SSL-Roots/Circuit_MainBoard/MainCircuit - シート1.pdf

Part | Value | 耐圧・電力 | Package | 購入先 | 単価
+B-CONE | XT60 | - | XT60 | amazon | ¥129.00
FUSE | 3413.0328.22(8A) | 8A | 3216 | DigiKey | ¥44.50
BOOST_CONE | B12B-XASK-1 | - | XA12pin | RS | ¥96.10
C100 | 0.01u | 25V | C1608 | 秋月電子 | ¥1.00
C102 | 0.1u | 25V | C1608 | 秋月電子 | ¥2.00
C103 | 0.1u | 25V | C1608 | 秋月電子 | ¥2.00
C104 | 0.1u | 25V | C1608 | 秋月電子 | ¥2.00
C105 | 10u | 25V | C2012 | 秋月電子 | ¥5.00
C150 | 100u | 25V | 6ｍｍ | 秋月電子 | ¥10.00
C151 | 100u | 25V | 6ｍｍ | 秋月電子 | ¥10.00
C152 | 100u | 25V | 6ｍｍ | 秋月電子 | ¥10.00
C153 | 100u | 25V | 6ｍｍ | 秋月電子 | ¥10.00
C201 | 0.01u | 25V | C1608 | 秋月電子 | ¥1.00
C202 | 0.01u | 25V | C1608 | 秋月電子 | ¥1.00
C203 | 0.01u | 25V | C1608 | 秋月電子 | ¥1.00
C204 | 0.01u | 25V | C1608 | 秋月電子 | ¥1.00
C205 | 0.1u | 25V | C1608 | 秋月電子 | ¥2.00
C206 | 0.1u | 25V | C1608 | 秋月電子 | ¥2.00
C207 | 0.1u | 25V | C1608 | 秋月電子 | ¥2.00
C208 | 0.1u | 25V | C1608 | 秋月電子 | ¥2.00
C301 | 0.1u | 25V | C1608 | 秋月電子 | ¥2.00
C302 | 0.1u | 25V | C1608 | 秋月電子 | ¥2.00
C303 | 0.1u | 25V | C1608 | 秋月電子 | ¥2.00
C305 | 0.1u | 25V | C1608 | 秋月電子 | ¥2.00
C306 | 1u | 50V | C1608 | 秋月電子 | ¥1.20
C307 | 1u | 50V | C1608 | 秋月電子 | ¥1.20
C308 | 0.047u | 50V | C1608 | 秋月電子 | ¥2.00
C400 | 未実装 | - | C1608 | - | -
C401 | 1u | 50V | C1608 | 秋月電子 | ¥1.20
C402 | 100u | 25V | 6ｍｍ | 秋月電子 | ¥10.00
C500 | 0.047u | 50V | C1608 | 秋月電子 | ¥2.00
D100 | HRF502A | - | DO214AC | 秋月電子 | ¥50.00
D400 | 未実装 | - | 1608 | - | -
D401 | CDBA3150-HF | - | DO214AC | DigiKey | ¥49.60
DISP300 | AQM0802A-RN-GBW | - | AQM0802A-RN-GBW | 秋月電子 | ¥320.00
IC100 | V7805-0.5 | 0.5A | V7805-0.5 | 秋月電子 | ¥350.00
IC101 | 7812 | 1A | TO220 | 秋月電子 | ¥50.00
IC102 | LD1117 | 1A | SOT223 | DigiKey | ¥69.70
IC300 | NUCLEO-F303K8 | - | NUCLEO-32 | 秋月電子 | ¥1,600.00
IC300用 | ピンソケット (メス) 1×32 (32P) | - | 30ピン | 秋月電子 | ¥70.00
IC301 | MCP2551 | - | SOIC-8 | DigiKey | ¥126.00
IC302 | 24LC64T | - | SO-08 | DigiKey | ¥53.00
IG&DIS-CONE | B04B-XASK-1 | - | XA4pin | DigiKey | ¥33.00
JP1 | 丸ピンICソケット (シングル40P) | - | 1X02 | 秋月電子 | ¥7.50
LC300 | VFS6V | - | VFS6V | 秋月電子 | ¥25.00
LED1 | OSDR3133A | - | LED3MM | 秋月電子 | ¥3.50
M1 | XBEE S1 | - | - | 秋月電子 | ¥2,500.00
M1用ソケット | 2mmピッチコネクタ*2個 | - | 10P | 秋月電子 | ¥60.00
MD500 | 丸ピンICソケット (シングル40P) | - | 12ピン | 秋月電子 | ¥45.00
MD501 | 丸ピンICソケット (シングル40P) | - | 12ピン | 秋月電子 | ¥45.00
MD502 | 丸ピンICソケット (シングル40P) | - | 12ピン | 秋月電子 | ¥45.00
Q100 | 2SJ334 | - | TO220V | 秋月電子 | ¥150.00
Q400 | 2SC3325 | - | SOT23 | 秋月電子 | ¥5.00
Q401 | 2SC3325 | - | SOT23 | 秋月電子 | ¥5.00
Q402 | 2SA1313 | - | SOT23 | 秋月電子 | ¥5.00

Q403 | NP52N06SLG | - | TO-252 | 秋月電子 | ¥20.00
R100 | 100 | 1/10W | R1608 | 秋月電子 | ¥0.20
R101 | 100k | 1/10W | R1608 | 秋月電子 | ¥0.20
R200 | 10k | 1/10W | R1608 | 秋月電子 | ¥0.20
R201 | 10k | 1/10W | R1608 | 秋月電子 | ¥0.20
R202 | 10k | 1/10W | R1608 | 秋月電子 | ¥0.20
R203 | 10k | 1/10W | R1608 | 秋月電子 | ¥0.20
R204 | 10k | 1/10W | R1608 | 秋月電子 | ¥0.20
R205 | 10k | 1/10W | R1608 | 秋月電子 | ¥0.20
R206 | 10k | 1/10W | R1608 | 秋月電子 | ¥0.20
R207 | 10k | 1/10W | R1608 | 秋月電子 | ¥0.20
R300 | 10k | 1/10W | R1608 | 秋月電子 | ¥0.20
R301 | 10k | 1/10W | R1608 | 秋月電子 | ¥0.20
R304 | 10k | 1/10W | R1608 | 秋月電子 | ¥0.20
R305 | 10k | 1/10W | R1608 | 秋月電子 | ¥0.20
R306 | 10k | 1/10W | R1608 | 秋月電子 | ¥0.20
R307 | 10k | 1/10W | R1608 | 秋月電子 | ¥0.20
R308 | 1k | 1/10W | R1608 | 秋月電子 | ¥0.20
R309 | 59 | 1/10W | R1608 | RS | ¥57.60
R310 | 59 | 1/10W | R1608 | RS | ¥57.60
R311 | 100k | 1/10W | R1608 | 秋月電子 | ¥0.20
R312 | 10k | 1/10W | R1608 | 秋月電子 | ¥0.20
R313 | 10k | 1/10W | R1608 | 秋月電子 | ¥0.20
R400 | 1k | 1/10W | R1608 | 秋月電子 | ¥0.20
R401 | 10k | 1/10W | R1608 | 秋月電子 | ¥0.20
R402 | 100k | 1/10W | R1608 | 秋月電子 | ¥0.20
R403 | 100 | 1/10W | R1608 | 秋月電子 | ¥0.20
R404 | 100k | 1/10W | R1608 | 秋月電子 | ¥0.20
R500 | 59 | 1/10W | R1608 | RS | ¥57.60
R501 | 59 | 1/10W | R1608 | RS | ¥57.60
S200 | タクトSW | - | B3F-10XXS | 秋月電子 | ¥10.00
S201 | タクトSW | - | B3F-10XXS | 秋月電子 | ¥10.00
S202 | タクトSW | - | B3F-10XXS | 秋月電子 | ¥10.00
S203 | タクトSW | - | B3F-10XXS | 秋月電子 | ¥10.00
S300 | DIPSW | - | DIP02YL | 秋月電子 | ¥50.00
SENS_CONE | 3B-XH-AB3B | - | B3B-XH-A | DigiKey | ¥28.40
U$30 | 未実装(4B-XH-AB4B) | - | B4B-XH-A | - | -
VARI100 | AVR-M2012C220KT6AB | - | R2012 | RS | ¥44.20
VARI400 | 未実装 | - | 2012 | - | -
VARI500 | 未実装 | - | 2012 | - | -
MCONE | B02B-XASK-1 | - | XA2pin | DigiKey | ¥21.60
ZD100 | 1SMA5931BT3G | - | DO214AC | RS | ¥35.30
基板 | - | - | - | elecrow | ¥738.44
| | | | 合計 | ¥7,239.84
