SSL-Roots/Circuit_MainBoard/回路図/MainCircuit.brd

## EAGLE design 回路図/MainCircuit.brd (2017-08-02)

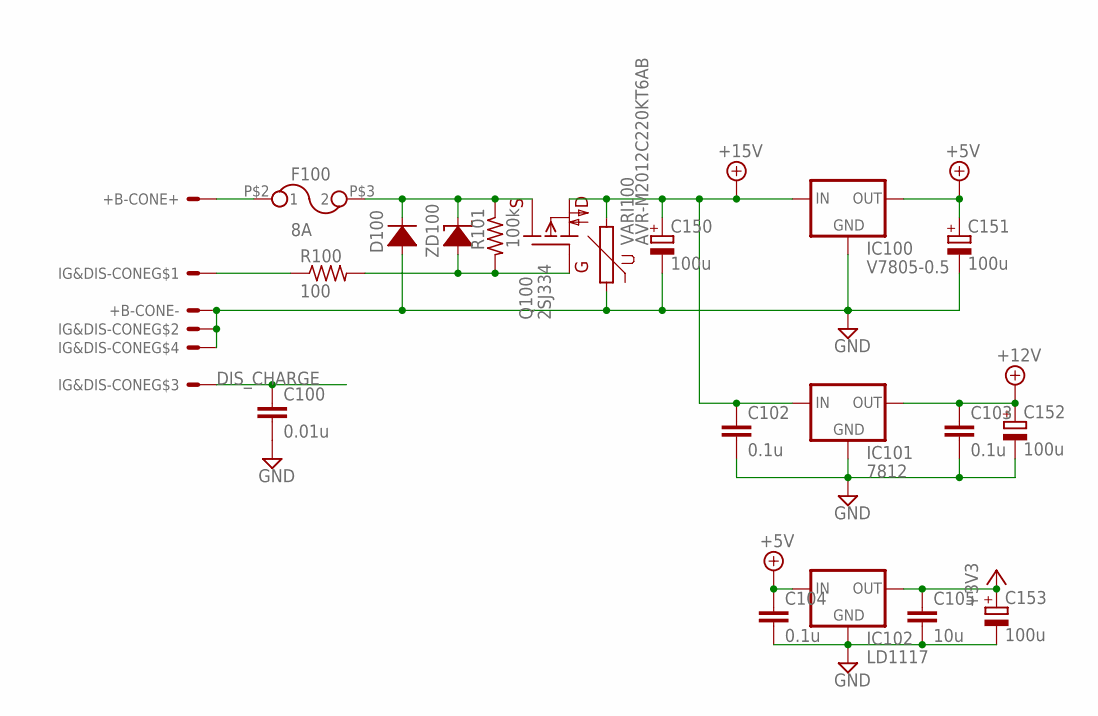
[picture p1: schematic MainCircuit.sch, sheet 1]

Parts:
+B-CONE: XT60
C100: 0.01u; C1608
C102, C103, C104: 0.1u; C1608
C105: 10u; C2012
C150, C151, C152, C153: 100u; E2,5-6
D100: DIODEDO214; DO214AC
FUSE: 8A; 3216
IC100: V7805-0.5
IC101: 7812; 78XXS
IC102: LD1117; SOT223
IG&DIS-CONE: 4B-XH-AB4B; B4B-XH-A
Q100: 2SJ334; TO220V
R100: 100; R1608
R101: 100k; R1608
VARI100: AVR-M2012C220KT6AB; 2012
ZD100: ZDIODEDO214AC; DO214AC

Connections:
+3V3: C105.1, C153.+, IC102.2 (OUT); also elsewhere on the board
+5V: C104.1, C151.+, IC100.+VOUT (OUT), IC102.3 (IN); also elsewhere on the board
+12V: C103.1, C152.+, IC101.OUT; also elsewhere on the board
+15V: C102.1, C150.+, IC100.+VIN (IN), IC101.IN, Q100.D, VARI100.2; also elsewhere on the board
DIS_CHARGE: C100.1, IG&DIS-CONE.3; also elsewhere on the board
GND: +B-CONE.-, C100.2, C102.2, C103.2, C104.2, C105.2, C150.-, C151.-, C152.-, C153.-, D100.A, IC100.GND, IC101.GND, IC102.1 (GND), IG&DIS-CONE.2, IG&DIS-CONE.4, VARI100.1; also elsewhere on the board
unnamed: IG&DIS-CONE.1, R100.1
unnamed: +B-CONE.+, FUSE.P$2 (1)
unnamed: D100.C, FUSE.P$3 (2), Q100.S, R101.1, ZD100.C (K)
unnamed: Q100.G, R100.2, R101.2, ZD100.A

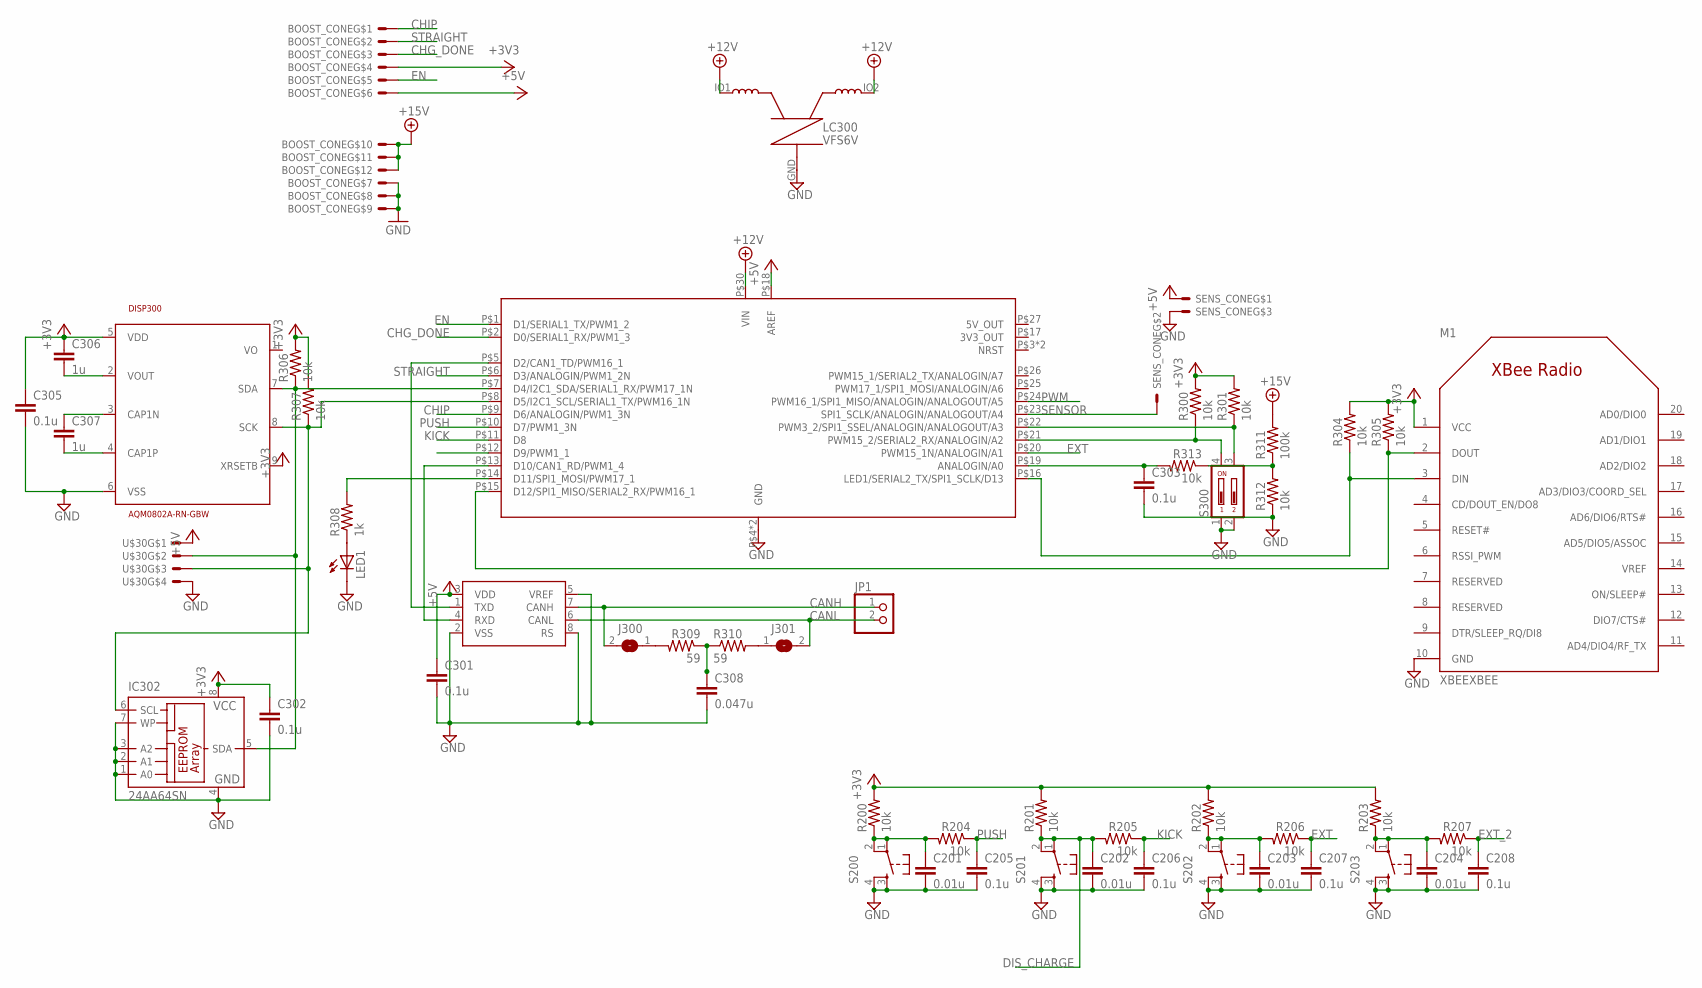
[picture p2: schematic MainCircuit.sch, sheet 2]

Parts:
BOOST_CONE: 12B-XH-AB12B; B12B-XH-A
C201, C202, C203, C204: 0.01u; C1608
C205, C206, C207, C208, C301, C302, C303, C305: 0.1u; C1608
C306, C307: 1u; C1608
C308: 0.047u; C1608
DISP300: AQM0802A-RN-GBW
IC300: NUCLEO-F303K8; NUCLEO-32
IC301: MCP2551; SOIC-8
IC302: 24AA64SN; SO-08
J300, J301: SJ
JP1: PINHD-1X2; 1X02
LC300: VFS6V
LED1: LED3MM
M1: XBEEXBEE; XBEE
R200, R201, R202, R203, R204, R205, R206, R207, R300, R301, R304, R305, R306, R307, R312, R313: 10k; R1608
R308: 1k; R1608
R309, R310: 59; R1608
R311: 100k; R1608
S200, S201, S202, S203: T-SWITCH; B3F-10XXS
S300: DIP02YL
SENS_CONE: 3B-XH-AB3B; B3B-XH-A
U$30: 4B-XH-AB4B; B4B-XH-A

Connections:
+3V3: BOOST_CONE.4, C302.1, C305.1, C306.1, DISP300.5 (VDD), DISP300.9 (XRSETB), IC302.8 (VCC), M1.1 (VCC), R200.2, R201.2, R202.2, R203.2, R300.2, R301.2, R304.2, R305.2, R306.2, R307.2; also elsewhere on the board
+5V: BOOST_CONE.6, C301.1, IC300.P$18 (AREF), IC301.3 (VDD), SENS_CONE.1, U$30.1; also elsewhere on the board
+12V: LC300.IO1; also elsewhere on the board
+12V": IC300.P$30 (VIN), LC300.IO2
+15V: BOOST_CONE.10, BOOST_CONE.11, BOOST_CONE.12, R311.2; also elsewhere on the board
CANH: IC301.7 (CANH), J300.2, JP1.1; also elsewhere on the board
CANL: IC301.6 (CANL), J301.2, JP1.2; also elsewhere on the board
CHG_DONE: BOOST_CONE.3, IC300.P$2 (D0/SERIAL1_RX/PWM1_3)
CHIP: BOOST_CONE.1, IC300.P$9 (D6/ANALOGIN/PWM1_3N)
DIS_CHARGE: C202.1, R201.1, R205.2, S201.1, S201.2 (P1); also elsewhere on the board
EN: BOOST_CONE.5, IC300.P$1 (D1/SERIAL1_TX/PWM1_2)
EXT: C207.1, IC300.P$20 (PWM15_1N/ANALOGIN/A1), R206.1
EXT_2: C208.1, IC300.P$12 (D9/PWM1_1), R207.1
GND: C201.2, C202.2, C203.2, C204.2, C205.2, C206.2, C207.2, C208.2, C301.2, C302.2, C303.2, C305.2, C308.2, DISP300.6 (VSS), IC300.P$4 (GND), IC300.P$29 (GND), IC301.2 (VSS), IC301.5 (VREF), IC301.8 (RS), IC302.1 (A0), IC302.2 (A1), IC302.3 (A2), IC302.4 (GND), IC302.7 (WP), LC300.GND, LED1.K (C), M1.10 (GND), R312.1, S200.3 (S), S200.4 (S1), S201.3 (S), S201.4 (S1), S202.3 (S), S202.4 (S1), S203.3 (S), S203.4 (S1), S300.1, S300.2, SENS_CONE.3, U$30.4; also elsewhere on the board
KICK: C206.1, IC300.P$11 (D8), R205.1
unnamed: C306.2, DISP300.2 (VOUT)
unnamed: C307.1, DISP300.3 (CAP1N)
unnamed: C307.2, DISP300.4 (CAP1P)
unnamed: C308.1, R309.1, R310.1
unnamed: J300.1, R309.2
unnamed: J301.1, R310.2
unnamed: R311.1, R312.2, R313.1
unnamed: IC300.P$22 (PWM3_2/SPI1_SSEL/ANALOGIN/ANALOGOUT/A3), R301.1, S300.3
unnamed: IC300.P$13 (D10/CAN1_RD/PWM1_4), IC301.4 (RXD)
unnamed: IC300.P$5 (D2/CAN1_TD/PWM16_1), IC301.1 (TXD)
unnamed: LED1.A, R308.1
unnamed: IC300.P$14 (D11/SPI1_MOSI/PWM17_1), R308.2
unnamed: IC300.P$15 (D12/SPI1_MISO/SERIAL2_RX/PWM16_1), M1.2 (DOUT), R305.1
unnamed: IC300.P$16 (LED1/SERIAL2_TX/SPI1_SCLK/D13), M1.3 (DIN), R304.1
unnamed: IC300.P$21 (PWM15_2/SERIAL2_RX/ANALOGIN/A2), R300.1, S300.4
unnamed: C303.1, IC300.P$19 (ANALOGIN/A0), R313.2
unnamed: C203.1, R202.1, R206.2, S202.1, S202.2 (P1)
unnamed: C204.1, R203.1, R207.2, S203.1, S203.2 (P1)
unnamed: C201.1, R200.1, R204.2, S200.1, S200.2 (P1)
PGND: BOOST_CONE.7, BOOST_CONE.8, BOOST_CONE.9; also elsewhere on the board
PUSH: C205.1, IC300.P$10 (D7/PWM1_3N), R204.1
PWM: IC300.P$24 (PWM16_1/SPI1_MISO/ANALOGIN/ANALOGOUT/A5); also elsewhere on the board
SCK: DISP300.8 (SCK), IC300.P$8 (D5/I2C1_SCL/SERIAL1_TX/PWM16_1N), IC302.6 (SCL), R307.1, U$30.3
SDA: DISP300.7 (SDA), IC300.P$7 (D4/I2C1_SDA/SERIAL1_RX/PWM17_1N), IC302.5 (SDA), R306.1, U$30.2
SENSOR: IC300.P$23 (SPI1_SCLK/ANALOGIN/ANALOGOUT/A4), SENS_CONE.2
STRAIGHT: BOOST_CONE.2, IC300.P$6 (D3/ANALOGIN/PWM1_2N)

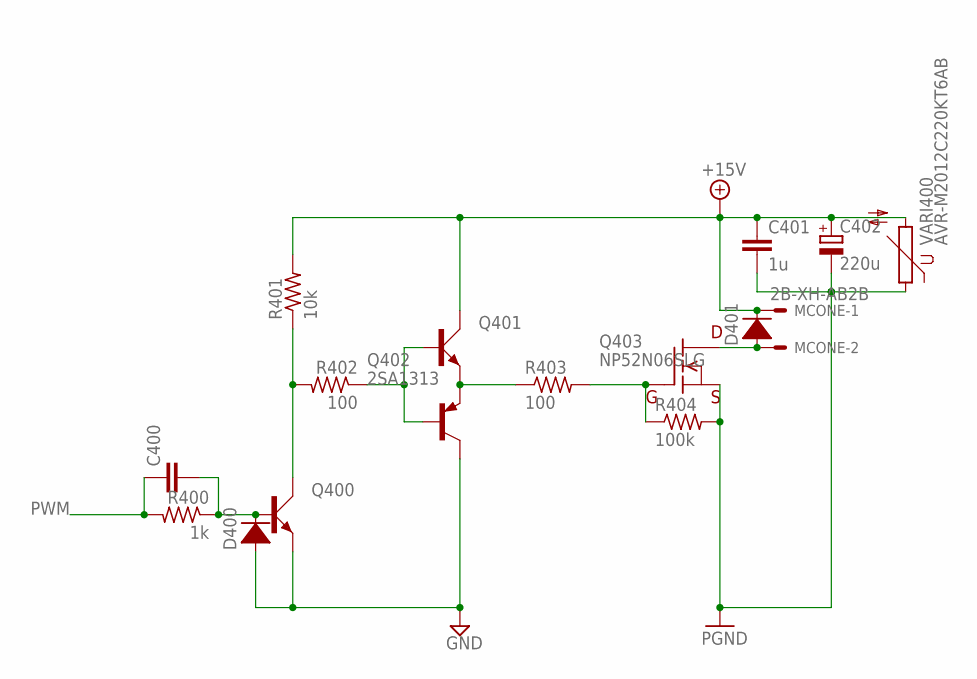
[picture p3: schematic MainCircuit.sch, sheet 3]

Parts:
C400: CC1608; C1608
C401: 1u; C1608
C402: 220u; E2,5-6
D400: DIODE1SS405; 1608
D401: DIODEDO214; DO214AC
MCONE: 2B-XH-AB2B; B2B-XH-A
Q400, Q401: 2SC3325; SOT23
Q402: 2SA1313; SOT23
Q403: NP52N06SLG; TO-252
R400: 1k; R1608
R401: 10k; R1608
R402, R403: 100; R1608
R404: 100k; R1608
VARI400: AVR-M2012C220KT6AB; 2012

Connections:
+15V: C401.1, C402.+, D401.C, MCONE.1, Q401.3 (C), R401.2, VARI400.2; also elsewhere on the board
GND: D400.A, Q400.2 (E), Q402.3 (C); also elsewhere on the board
unnamed: D401.A, MCONE.2, Q403.D
unnamed: Q401.2 (E), Q402.2 (E), R403.1
unnamed: Q403.G, R403.2, R404.1
unnamed: Q401.1 (B), Q402.1 (B), R402.1
unnamed: Q400.3 (C), R401.1, R402.2
unnamed: C400.2, D400.C, Q400.1 (B), R400.1
PGND: C401.2, C402.-, Q403.S, R404.2, VARI400.1; also elsewhere on the board
PWM: C400.1, R400.2; also elsewhere on the board

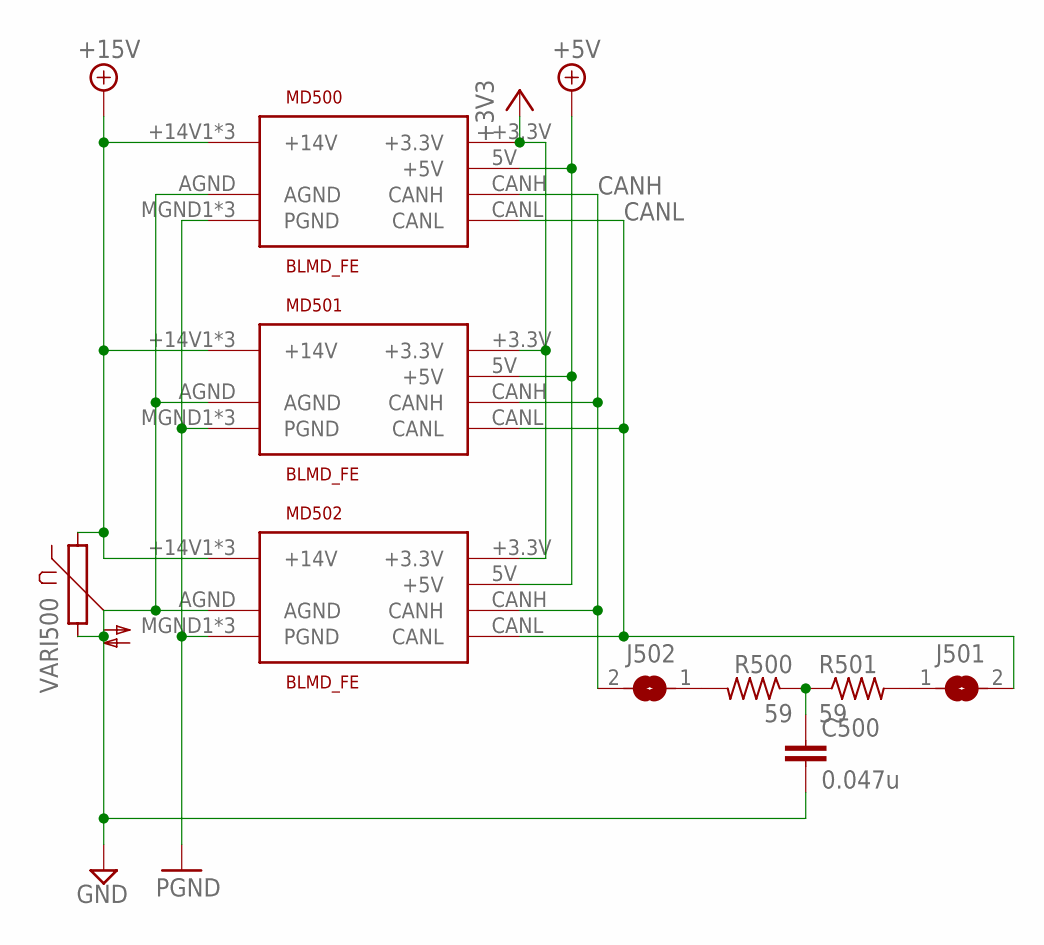
[picture p4: schematic MainCircuit.sch, sheet 4]

Parts:
C500: 0.047u; C1608
J501, J502: SJ
MD500, MD501, MD502: BLMD_FE; BLMD_TE
R500, R501: 59; R1608
VARI500: VARISTOR2012; 2012

Connections:
+3V3: MD500.+3.3V, MD501.+3.3V, MD502.+3.3V; also elsewhere on the board
+5V: MD500.5V (+5V), MD501.5V (+5V), MD502.5V (+5V); also elsewhere on the board
+15V: MD500.+14V1 (+14V), MD500.+14V2 (+14V), MD500.+14V3 (+14V), MD501.+14V1 (+14V), MD501.+14V2 (+14V), MD501.+14V3 (+14V), MD502.+14V1 (+14V), MD502.+14V2 (+14V), MD502.+14V3 (+14V), VARI500.1; also elsewhere on the board
CANH: J502.2, MD500.CANH, MD501.CANH, MD502.CANH; also elsewhere on the board
CANL: J501.2, MD500.CANL, MD501.CANL, MD502.CANL; also elsewhere on the board
GND: C500.2, MD500.AGND, MD501.AGND, MD502.AGND, VARI500.2; also elsewhere on the board
unnamed: C500.1, R500.1, R501.1
unnamed: J502.1, R500.2
unnamed: J501.1, R501.2
PGND: MD500.MGND1 (PGND), MD500.MGND2 (PGND), MD500.MGND3 (PGND), MD501.MGND1 (PGND), MD501.MGND2 (PGND), MD501.MGND3 (PGND), MD502.MGND1 (PGND), MD502.MGND2 (PGND), MD502.MGND3 (PGND); also elsewhere on the board

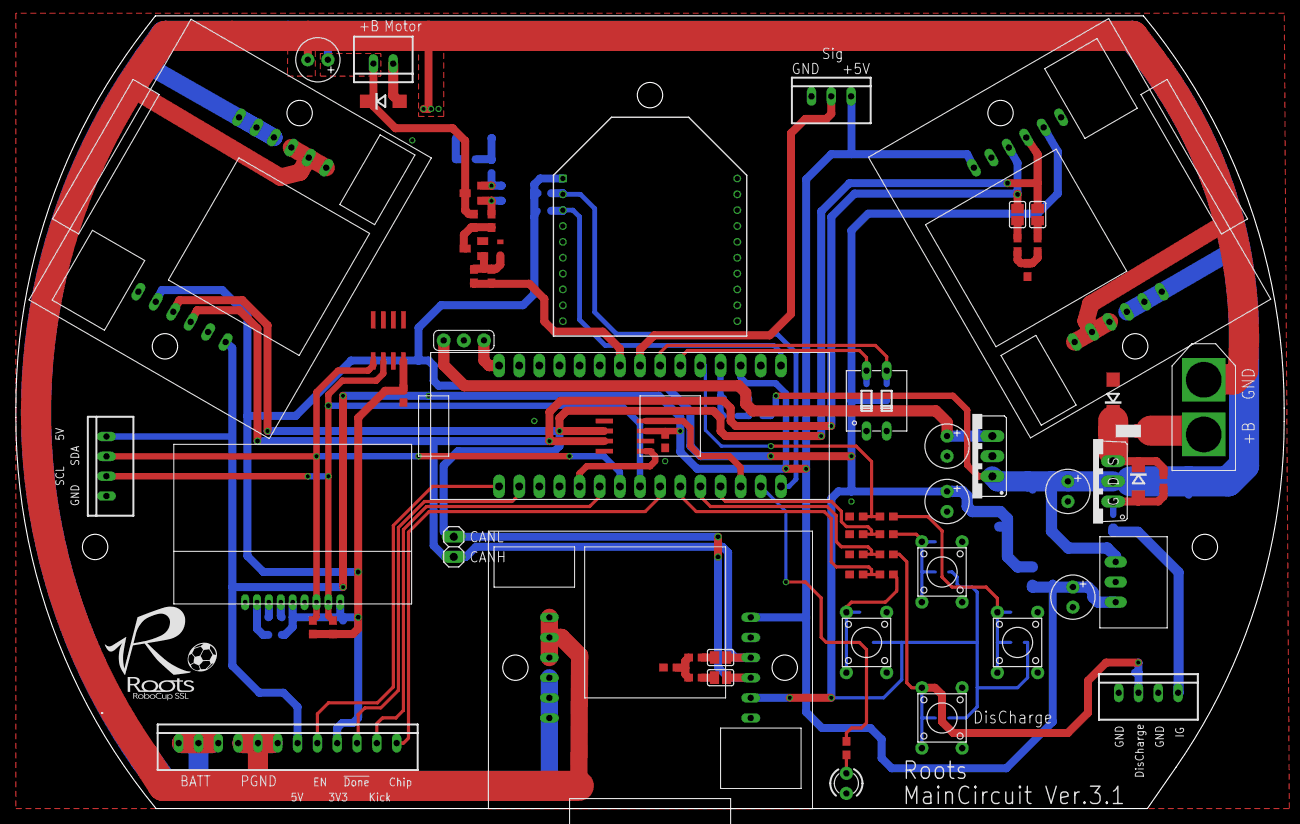
[picture p5: board MainCircuit.brd from above]

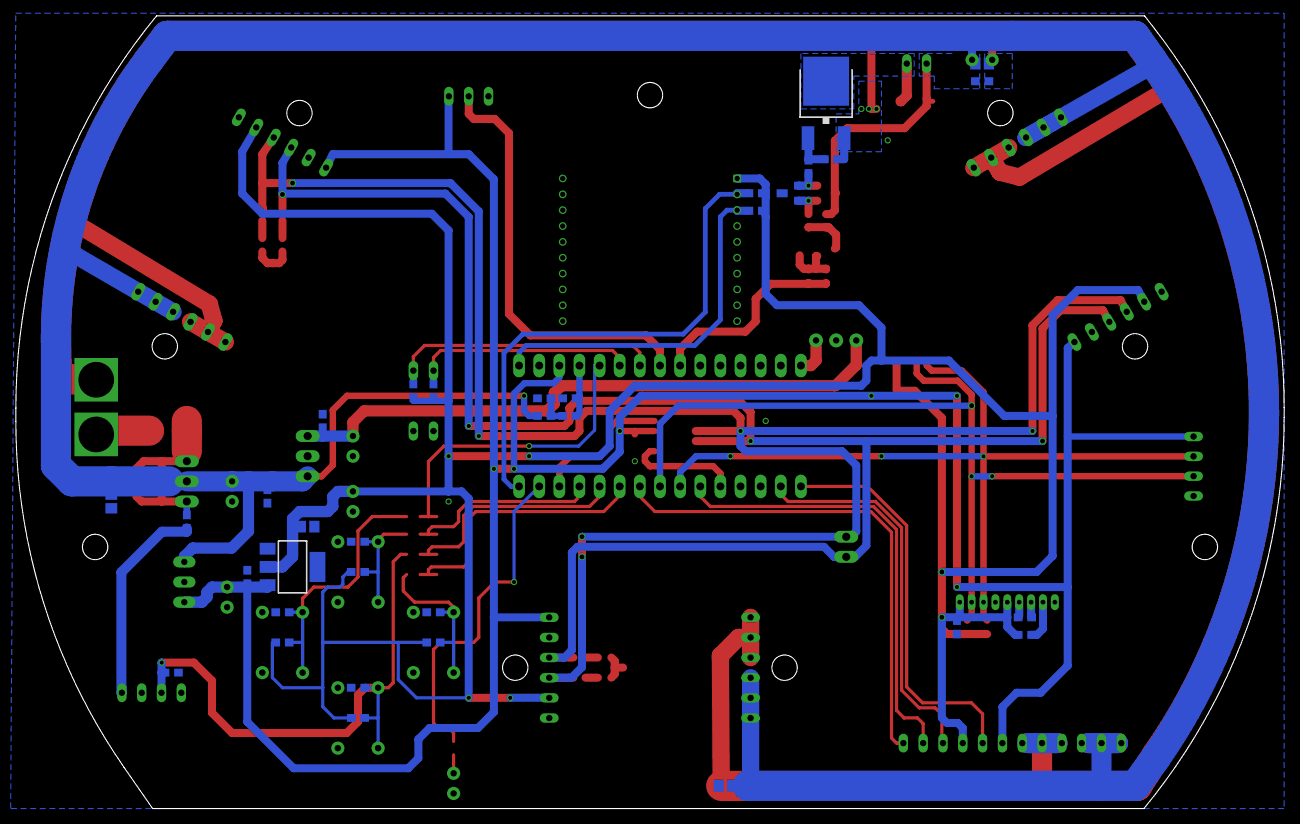
[picture p6: board MainCircuit.brd from below]

Board: 2 copper layers, 160.0 x 100.0 mm, 100 parts (34 on the bottom side), 54 nets.

Other parts of the board:
U$106: ROOTS
